b-etz/sky130_be_ip__lsxo/images/cace_results_startup_ena_20240401.png

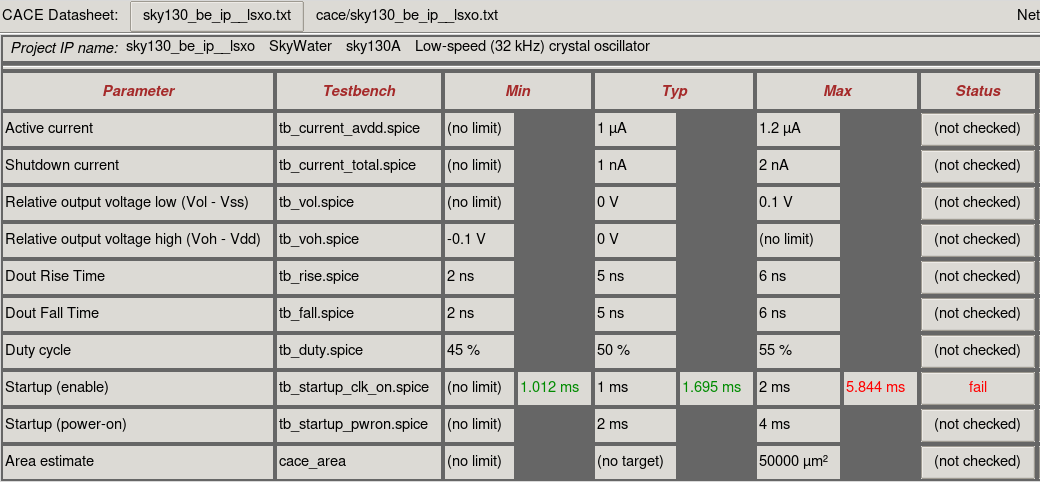
images/cace_results_startup_ena_20240401.png
