b-etz/sky130_be_ip__lsxo/(commit log)

2024-03-21 Initial schematic commit
    [dout_amp.sch, dout_amp_d.sch, ena_rip_dly.sch, level_shift.sch, level_shift_tiny.sch, lqfp_parasitics.sch, lsxo_bias_gen.sch, lsxo_top.sch]
2024-03-21 Normalized transistor widths and lengths to the PDK bin limits, for improved accuracy. Reduced core oscillator drive current to improve compatibility with 6pF CL devices. Removed unused schematics an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
    [dout_amp.sch, dout_amp_d.sch, level_shift.sch, level_shift_tiny.sch, lsxo_bias_gen.sch, lsxo_top.sch, tb_lsxo_general.sch, xtal_abs_040.sch]
2024-03-22 Reduce digital leakage 0.7nA in standby by lengthening both level shifter input stage and digital power gating FETs. Device now meets shutdown current spec. Fix simulation oddities from testbench IBI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
    [level_shift_tiny.sch, lsxo_top.sch, ripl_dly_clk_buf.sch, tb_lsxo_general.sch]
2024-03-22 Rename schematics for simplicity and clarity. Remove stale testbenches. Renumber subcircuits for clarity. Minor cosmetic improvements.
    [bias_gen.sch, dout_amp.sch, level_shift.sch, sky130_be_ip__lsxo.sch, tb_dout_amp.sch, tb_level_shift.sch, tb_sky130_be_ip__lsxo.sch, tb_xtal.sch]
2024-03-22 Partway through test CACE's. Standardized to 4-cycle ripple delays to reduce static power as measured by CACE. Pending additional testbenches and final formatting.
    [ena_rip_dly.sch, ripl_dly_clk_buf.sch, ripple_dly_4.sch, sky130_be_ip__lsxo.sch, tb_current.sch, tb_sky130_be_ip__lsxo.sch]
2024-03-23 Add CACE specification document for LSXO, almost final. Add more testbenches.
    [tb_duty.sch, tb_sky130_be_ip__lsxo.sch, tb_sky130_be_ip__lsxo_outputs.sch, tb_voh.sch, tb_vol.sch]
2024-03-23 Add final CACE testbenches for characterization. Eliminate unused schematics and testbenches. Rename manual testbench in the /xschem/ folder. Updated README.md.
    [lqfp_parasitics.sch, tb_current_avdd.sch, tb_current_total.sch, tb_dout_amp.sch, tb_duty.sch, tb_fall.sch, tb_man__sky130_be_ip__lsxo.sch, tb_rise.sch]
2024-03-25 File revisions from design review. Add current annotation to dout_amp.sch. Remove xschemrc from .gitignore. Update CACE datasheet to include voltage ranges to default_conditions. Update CACE datashee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
    [dout_amp.sch, lqfp_parasitics.sch, tb_man__sky130_be_ip__lsxo.sch]
2024-03-30 Modify bias_gen startup network to stabilize rapidly at all values of AVDD, which was one limiting factor in startup time at 2.7V. Optimize the output clock inverter to improve rise/fall symmetry and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
    [bias_gen.sch, dout_amp.sch, lqfp_parasitics.sch, ripl_dly_clk_buf.sch, ripple_dly_4.sch, sky130_be_ip__lsxo.sch, tb_man__bias.sch, tb_man__sky130_be_ip__lsxo.sch]
2024-03-31 Add .ic to duty cycle test to cut testing runtime down to under 1 hour; also removes confounding effects from startup. Add time delay to startup 'meas' directives to prevent midpoint fluctuations bef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
    [sky130_be_ip__lsxo.sch, tb_duty.sch, tb_man__bias.sch, tb_man__sky130_be_ip__lsxo.sch, tb_man__vol.sch, tb_startup_clk_on.sch, tb_startup_pwron.sch, tb_voh.sch]
2024-04-01 One last simulation-time update - include a useful plot of startup behavior over 1.5 seconds. Instructive for GitHub readers. Add to README.md.
    [sky130_be_ip__lsxo.sch, tb_duty.sch, tb_man__sky130_be_ip__lsxo.sch]
2024-04-02 Last decap adjustment before layout. Reduced size of decaps, leaving about 6pF on dvdd_ip. Updated performance characterization image and README.md.
    [sky130_be_ip__lsxo.sch]
2024-04-02 Buffer 'ena' and 'standby' inputs before distributing to IP. Slight increase in static power (~10 pA).
    [dout_amp.sch, sky130_be_ip__lsxo.sch, tb_man__sky130_be_ip__lsxo.sch]
2024-04-02 Initial Magic import for sky130_be_ip__lsxo.
    [bias_gen.sch, sky130_be_ip__lsxo.sch]
2024-04-02 Vague floorplanning placement for IP subblocks. Slight refinements to subblock structure.
    [sky130_be_ip__lsxo.sch]
2024-04-03 Add experimental echo alternative data path for CACE data summaries. Reduces memory usage but fails to summarize results and returns some bogus values.
    [tb_current_avdd.sch, tb_current_total.sch, tb_duty.sch, tb_fall.sch, tb_rise.sch, tb_startup_clk_on.sch, tb_startup_pwron.sch, tb_voh.sch]
2024-04-04 Complete more preliminary floorplanning. Power domains will be dvdd/dvss (main substrate), avdd/avss (small deep n-well), avdd_ip/avss_ip (deep n-well in lower-left corner), dvdd_ip/dvss_ip (deep n-w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
2024-04-07 level_shift layout first iteration complete
    [sky130_be_ip__lsxo.sch]
2024-04-08 Refine ripple delay layout.
    [sky130_be_ip__lsxo.sch]
2024-04-11 Flatten bias_gen circuit into top level layout for ease of placement. Tweak rough floorplan.
    [bias_gen.sch, dout_amp.sch]
2024-04-11 Flatten dout_amp cell instances into top level to ease layout. Further minor layout tweaks.
    [dout_amp.sch]
2024-04-11 MIMcap layout mostly finalized. Final packed dimensions ~120um x 120um.
    [bias_gen.sch]
2024-04-11 Final layout for ripple delay buffer. Add substrate taps for that subcell.
    [bias_gen.sch, ripl_dly_clk_buf.sch]
2024-04-12 Fix DRC errors related to taps with standard cells. Second revision for ripple delay buffer subcircuit.
    [sky130_be_ip__lsxo.sch]
2024-04-12 Fingers crossed, final deep n-well layout. On to routing.
    [bias_gen.sch, dout_amp.sch]
2024-04-13 Majority of bias_gen and core oscillator layout complete (avdd_ip domain). MIMcaps not yet routed. Next stage is dvdd_ip domain.
    [bias_gen.sch, sky130_be_ip__lsxo.sch]
2024-04-13 Digital layout mostly final. Remaining steps are power routing and MIMcap routing.
    [dout_amp.sch]
2024-04-14 Analog power routed. Analog routing nearly finished - MIMcaps remain.
2024-04-14 Analog power/signal routing complete. Digital power and final signal routing left.
2024-04-15 R-C extracted spice netlist in /mag directory. GDS in a dedicated /gds directory.
    [sky130_be_ip__lsxo.sch]
2024-04-15 Make DRC-clean GDS by reformatting affected parametrized cells to remove unwanted viali/mcon overlaps (generally widen m1/li/viali after). Re-enumerate all subcircuit ports, including internal labels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
    [bias_gen.sch, dout_amp.sch, level_shift.sch, ripl_dly_clk_buf.sch, ripple_dly_4.sch, sky130_be_ip__lsxo.sch]
2024-04-15 Add missing dummy nfet1v8 device to schematic. Add missing pfet5v0 device to schematic. Correct some incorrect dummy net assignments. LVS device type counts now match.
    [bias_gen.sch, dout_amp.sch, sky130_be_ip__lsxo.sch]
2024-04-15 Replace missing dnwell region in avss_ip domain. Fixed last parameter mismatches between dummy devices in schematic and layout. LVS passes with flattened layout file found in /mag/flattened/. R-C ext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
    [bias_gen.sch, dout_amp.sch, sky130_be_ip__lsxo.sch]
2024-04-16 Crawling through CACE characterizations of the C-extracted layout. Add GDS render to README.
    [tb_current_avdd.sch, tb_current_total.sch, tb_voh.sch, tb_vol.sch]
2024-04-17 Adding some testbench modifications to try to get R-C simulations to run.
    [tb_current_avdd.sch, tb_current_total.sch, tb_duty.sch, tb_fall.sch, tb_rise.sch, tb_startup_clk_on.sch, tb_startup_pwron.sch, tb_voh.sch]
2024-04-17 Add substrate tap fill between deep n-wells, connected to dvss. Add m1 ground strapping along substrate tap fill, except under the clock routes. Resize the dvdd label for ripl_dly_clk_buf to prevent 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
    [sky130_be_ip__lsxo.sch, tb_man__vol.sch]
2024-04-17 Update README.md with recommended parts, all intended for testing on post-silicon boards. Update IP layout image. Regenerate parasitic extractions.
2024-04-23 Bonus feature (external oscillator bypass) degradation with the addition of protection diodes. Added information to README.md.
    [sky130__test_diode.sch, sky130_be_ip__lsxo.sch, tb_current_avdd.sch, tb_current_total.sch, tb_man__sky130_be_ip__lsxo.sch]
2024-04-24 Update README with LVS schematic CACE results capture. Remove obsolete image files. Ongoing testbench tweaks to work with RCX netlists.
    [tb_duty.sch, tb_man__sky130_be_ip__lsxo.sch, test_diode_custom.sch]
2024-04-24 Diode testing in the sky130_be_ip__lsxo schematic left floating nodes on pdiode cathode where should have been. Reverted to correct LVS. Rerunning CACE sims.
    [sky130_be_ip__lsxo.sch]
2024-04-25 Add Layout Extracted testbench results to documentation. Clarify ESD protection resistor on integrated I/O is acceptable in series with crystal. Minor changes to CACE testbenches - tested .meas usage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
    [tb_fall.sch, tb_rise.sch]
2024-05-03 Modified .mag files to make corrections for tapeout (mostly to resolve MiM cap bottom plate spacing rule). Removed intermediate .ext files from the repository.
2024-06-04 Adding in the files associated with running LVS, DRC, Schematic and Layout extraction from the command line.
    Layout extraction still not working in this commit. All others run and work.
2024-09-10 added cace support
    [lqfp_parasitics.sch, tb_current_avdd.sch, tb_current_total.sch, tb_duty.sch, tb_fall.sch, tb_rise.sch, tb_startup_clk_on.sch, tb_startup_pwron.sch]
2025-02-09 Update README example crystals so all are 2x1.2 mm
